sandun21/ppg-sensor/(list of files, drawings)

Other design files:
pcb/PcbLib1.PcbLib
pcb/Schlib1.SchLib
pcb/Sheet1.SchDoc
pcb/SPO2_Sensor.PrjPcb
